gabrielarotver/trashPickupRobotCode/capstoneReportTitlePage.xlsx

 | THE HELPER
 | PROJECT
SENIOR CAPSTONE DESIGN REPORT
 |  | Dary Cabrera
 |  | Gabriela Rotver
 |  | Sheik Rahaman
 |  | 2016-01-29
